aderusha/Tormek_T-4_Rotating_Base/images/Inner_retaining_ring_glue_and_lube_surfaces.png

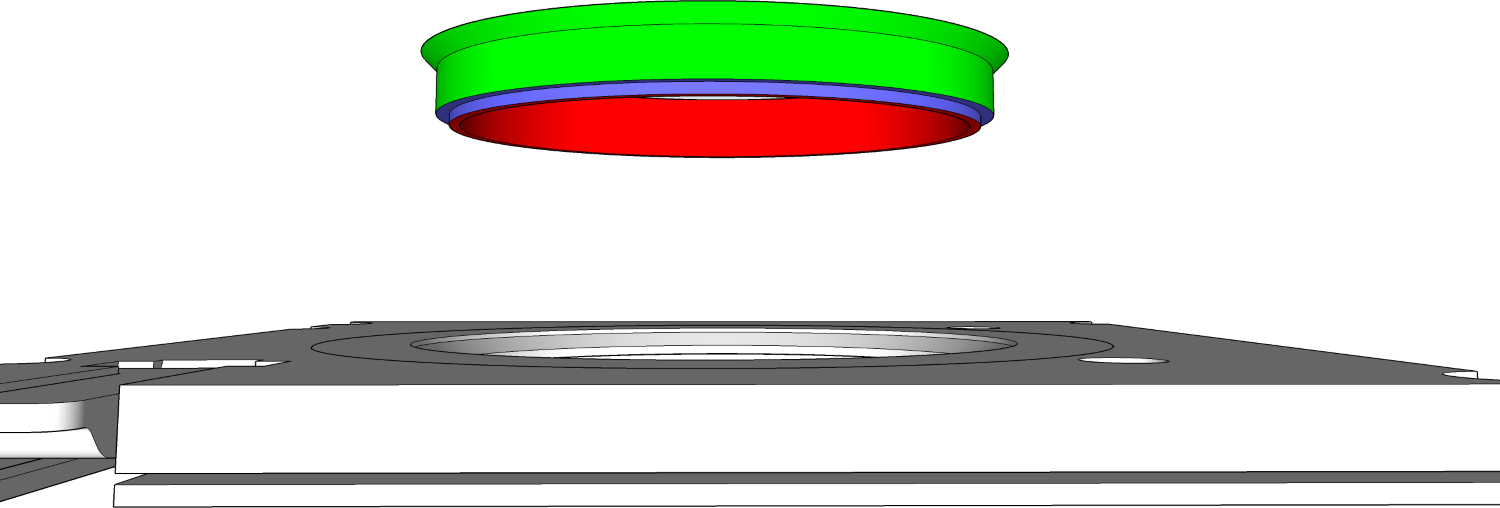
images/Inner_retaining_ring_glue_and_lube_surfaces.png
