aderusha/Tormek_T-4_Rotating_Base/images/Top_glue_surfaces.png

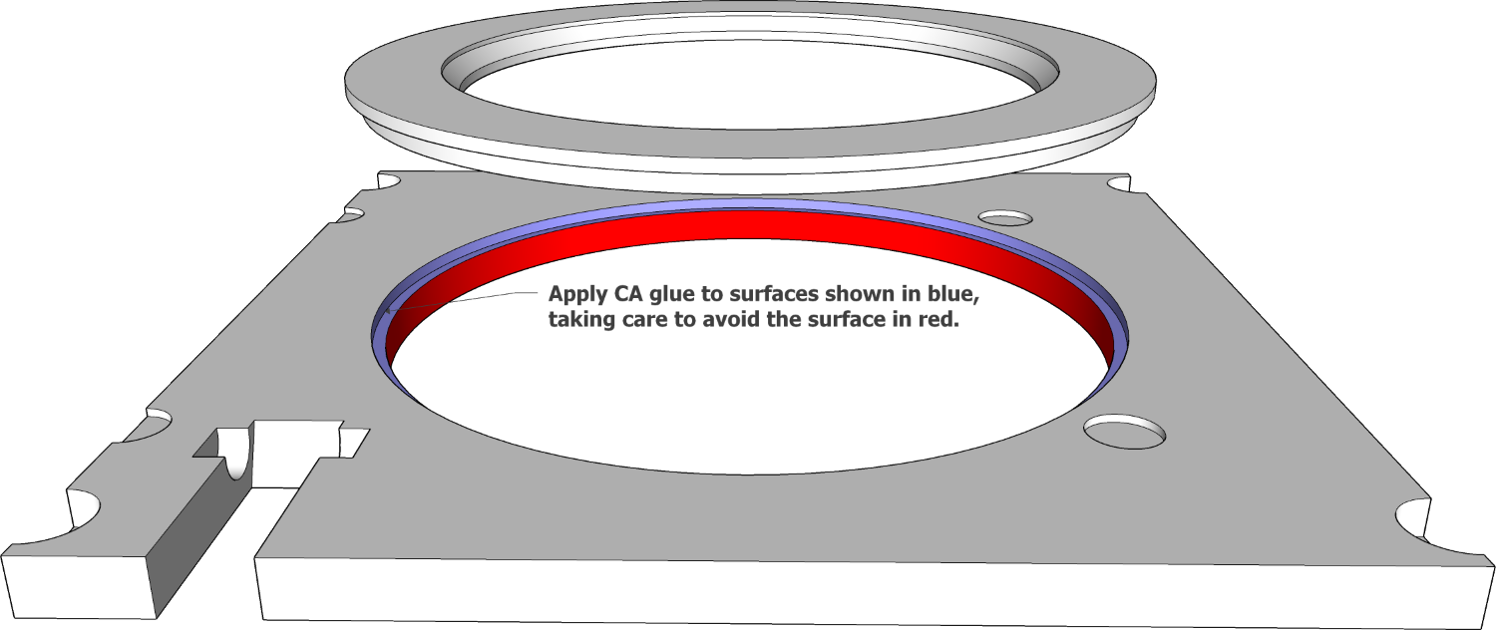
images/Top_glue_surfaces.png
