aderusha/Tormek_T-4_Rotating_Base/images/Tormek_T-4_Rotating_Base_X-Ray.png

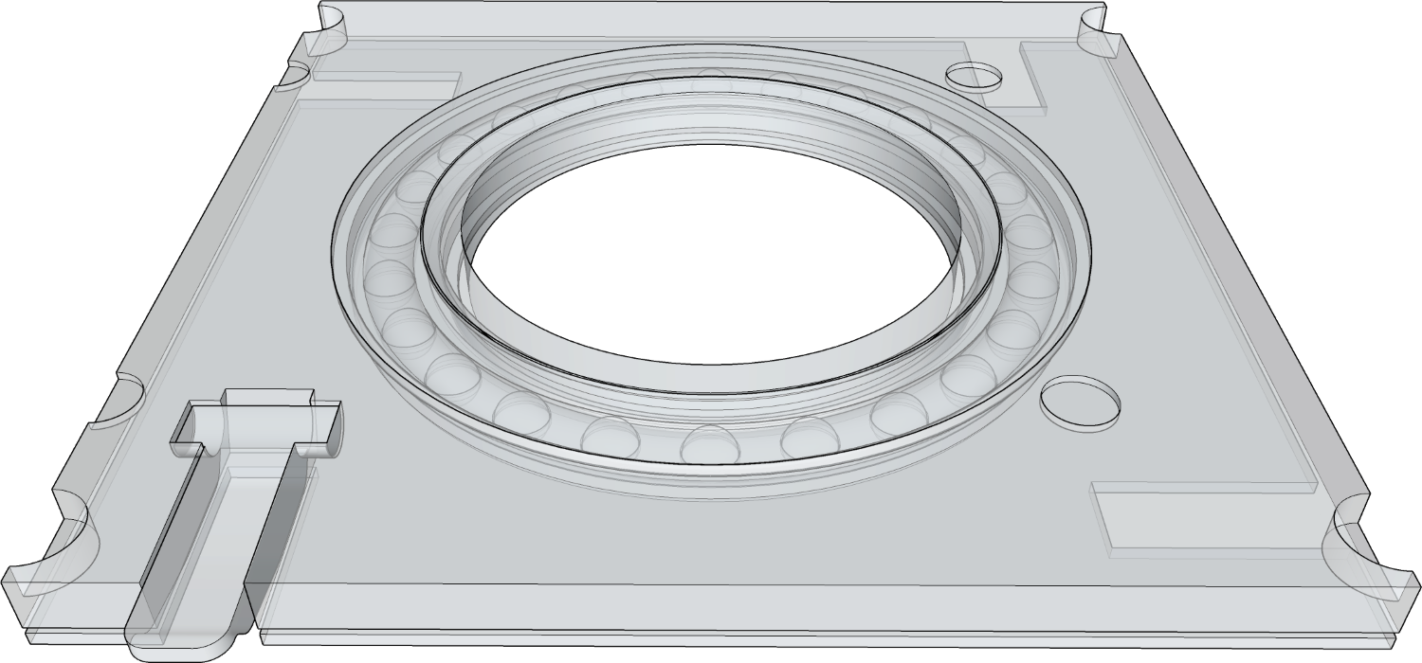
images/Tormek_T-4_Rotating_Base_X-Ray.png
