aderusha/Tormek_T-4_Rotating_Base/Top_Bearing_Raceway.stl

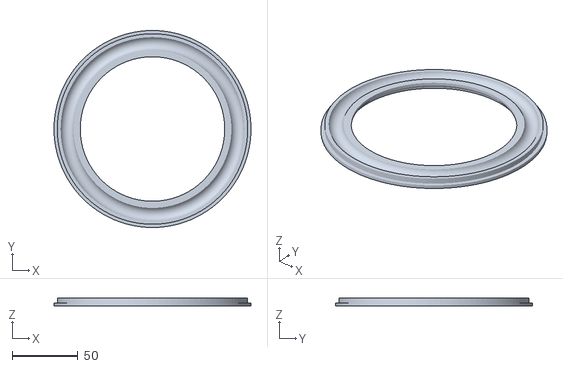
[picture p4: CAD file, 2022-06-04]
Top_Bearing_Raceway.stl
150.0 x 150.0 x 6.00
