aderusha/Tormek_T-4_Rotating_Base/Bearing_Spacer.stl

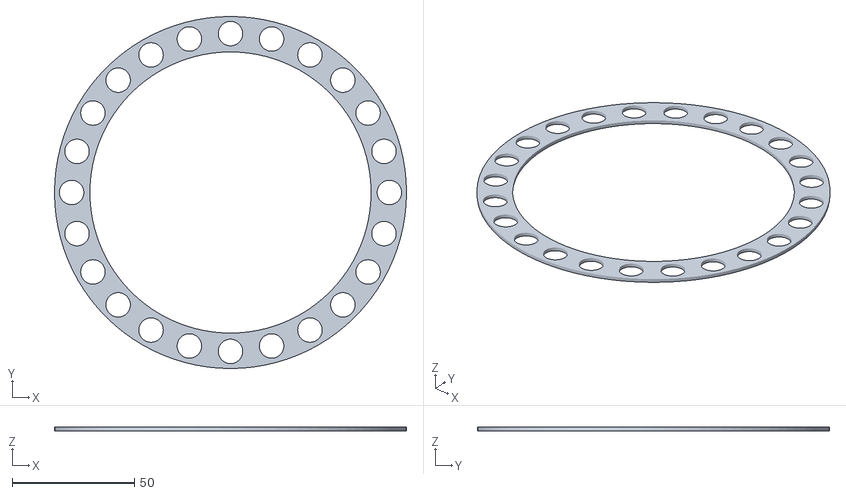
[picture p5: CAD file, 2022-06-04]
Bearing_Spacer.stl
144.0 x 144.0 x 1.50
