aderusha/Tormek_T-4_Rotating_Base/Top.stl

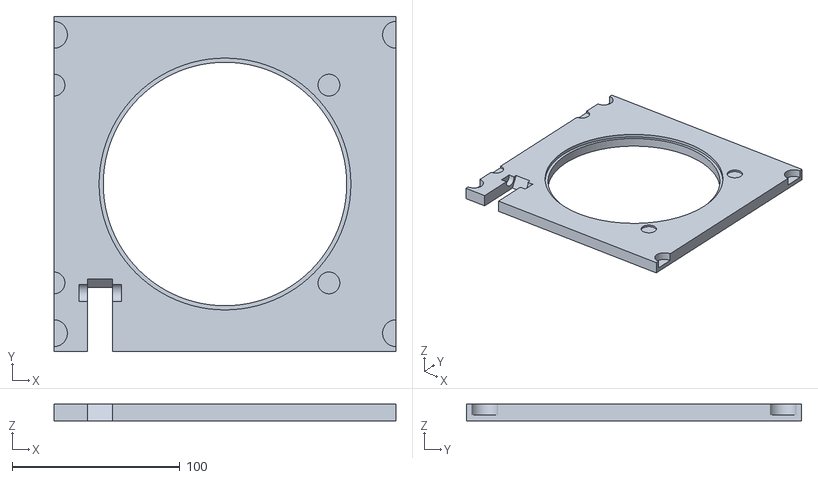
[picture p7: CAD file, 2022-06-04]
Top.stl
204.0 x 200.0 x 10.0
