aderusha/Tormek_T-4_Rotating_Base/Bottom_-_2_side_detent.stl

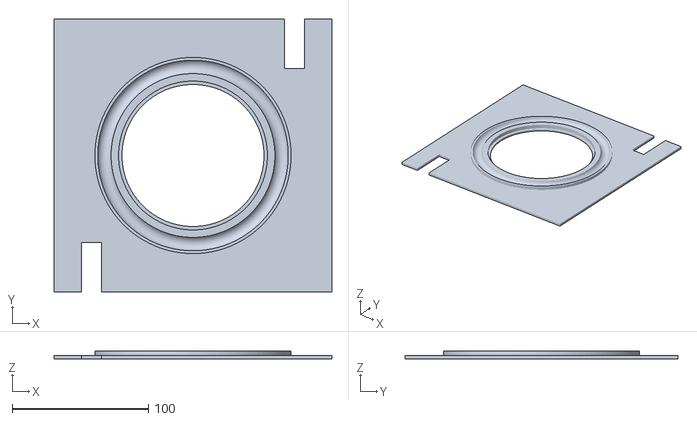
[picture p8: CAD file, 2022-06-04]
Bottom_-_2_side_detent.stl
204.0 x 200.0 x 5.75
