aderusha/Tormek_T-4_Rotating_Base/Inner_Retaining_Ring.stl

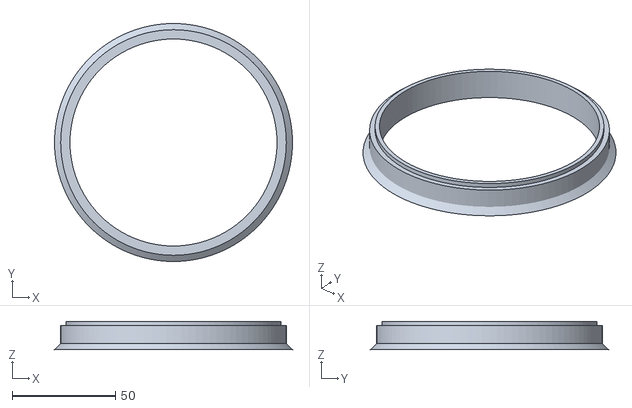
[picture p10: CAD file, 2022-06-04]
Inner_Retaining_Ring.stl
115.0 x 115.0 x 13.8
