aderusha/Tormek_T-4_Rotating_Base/Locking_Lever.stl

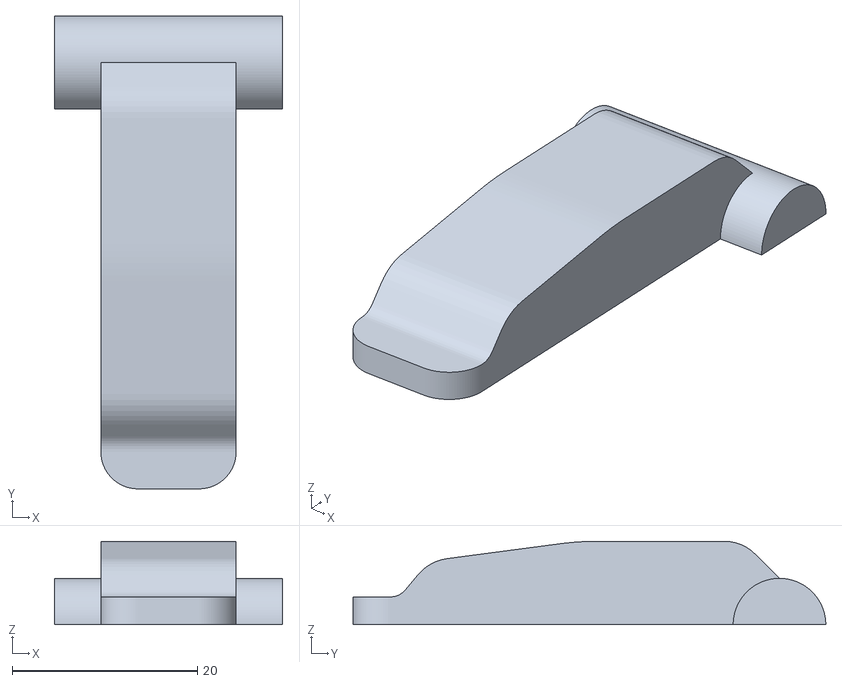
[picture p11: CAD file, 2022-06-04]
Locking_Lever.stl
24.6 x 51.0 x 9.00
